EstebanValverde/Infusion-pump/photos/IMG_20240315_102458.jpg

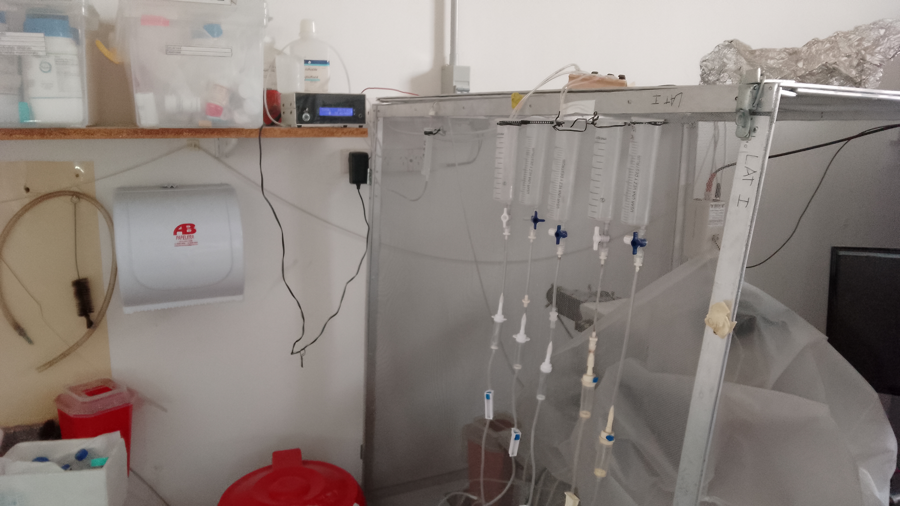
photos/IMG_20240315_102458.jpg
