EstebanValverde/Infusion-pump/photos/IMG_20240315_102521.jpg

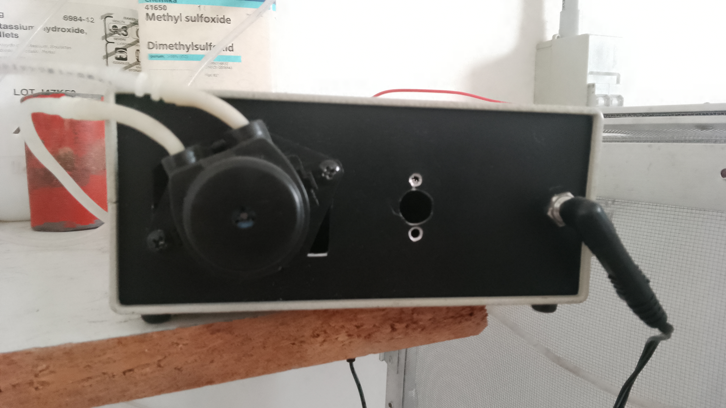
photos/IMG_20240315_102521.jpg
